ijazvic/Air-quality-monitoring/README.md

# Air-quality-monitoring
Measurement of air quality parameters, automatic control based on air quality, data visualization via Adafruit IO.

The documentation is fully completed, the code is final and functional, and there is a finished prototype of the system which is also fully operational. The code was written without using sensor libraries, and the sensor operation as well as all other additional explanations are included in the project documentation.
